tekkies/NodeMcu-LIS3DSH-MQTT-Accelerometer/sandbox/ESP-12E-Programmer/ESP-12E-Programmer-TinyCAD.png

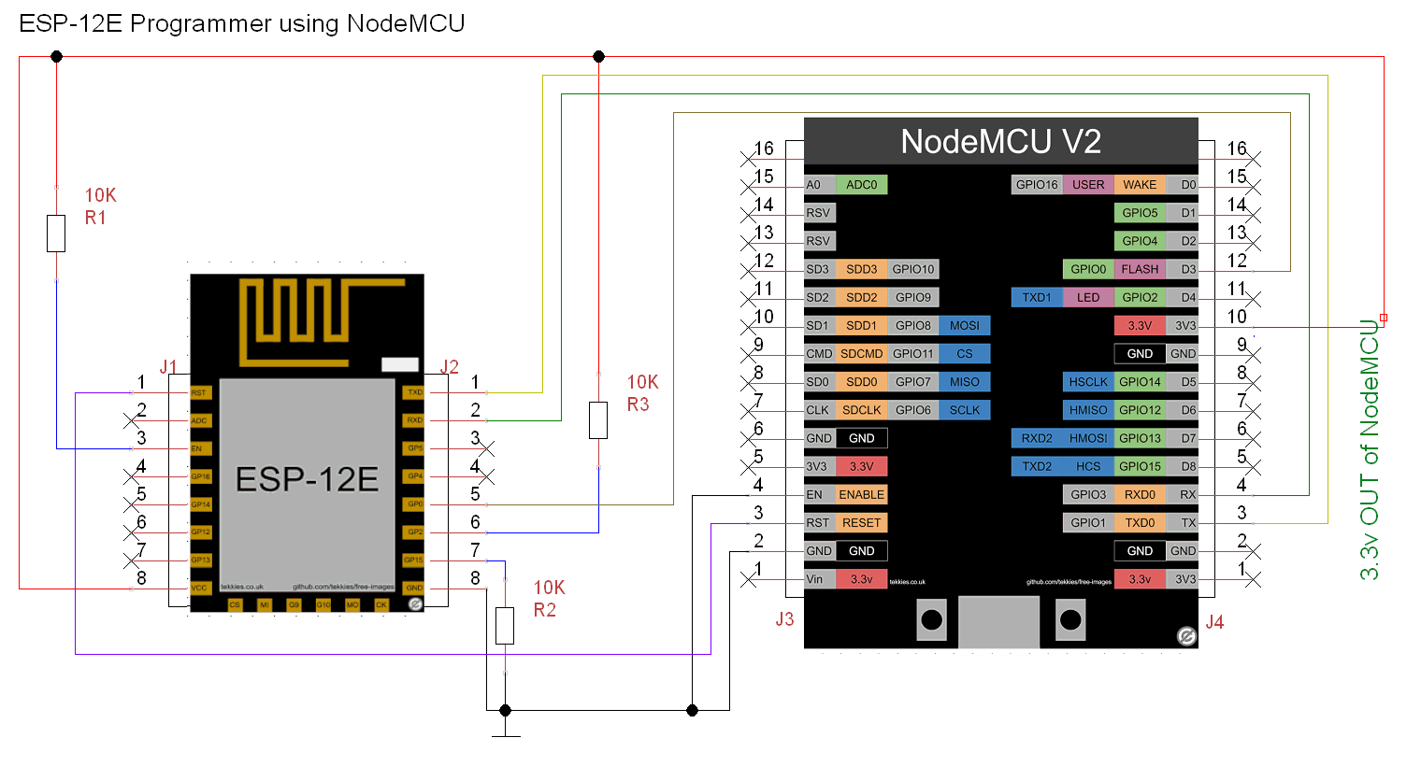
sandbox/ESP-12E-Programmer/ESP-12E-Programmer-TinyCAD.png
