tekkies/NodeMcu-LIS3DSH-MQTT-Accelerometer/hardware/NodeMCU-V2/Stripboard-Layout-FRONT.VeeCAD.pdf

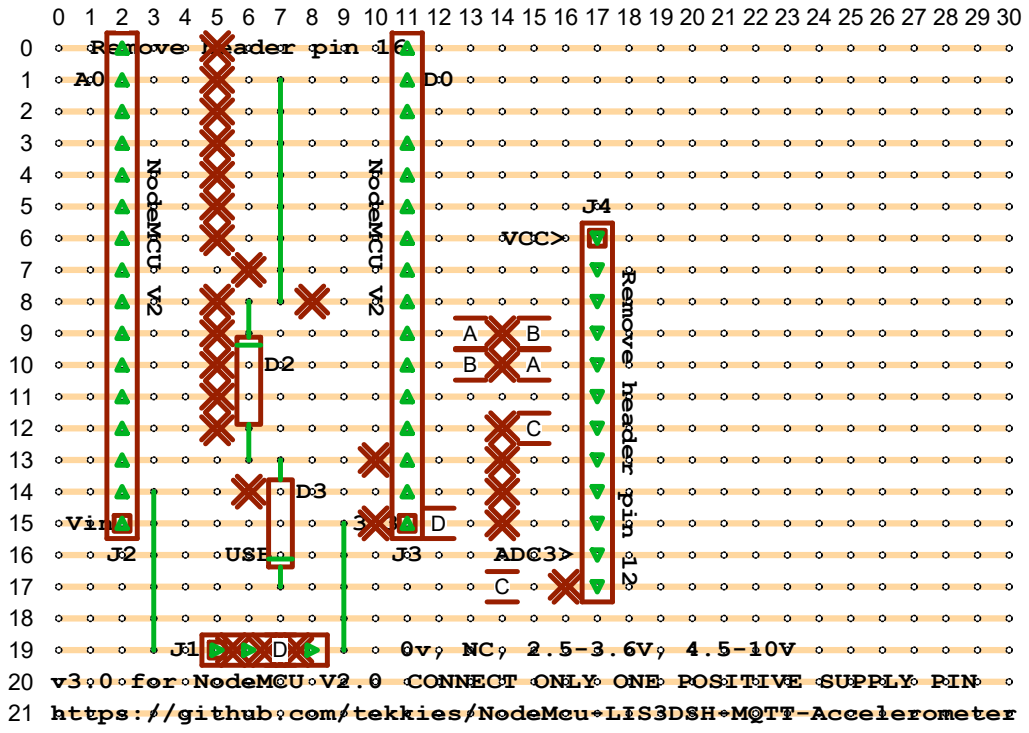
[picture p6: page 1]
ADC3>; VCC>; Remove header pin 16; Vin; USB; v3.0 for NodeMCU V2.0 https://github.com/tekkies/NodeMcu-LIS3DSH-MQTT-Accelerometer; CONNECT ONLY ONE POSITIVE SUPPLY PIN NodeMCU V2; NodeMCU V2; Remove header pin 12 A
