tekkies/NodeMcu-LIS3DSH-MQTT-Accelerometer/hardware/NodeMCU-V2/Stripboard-Layout-REAR.VeeCAD.pdf

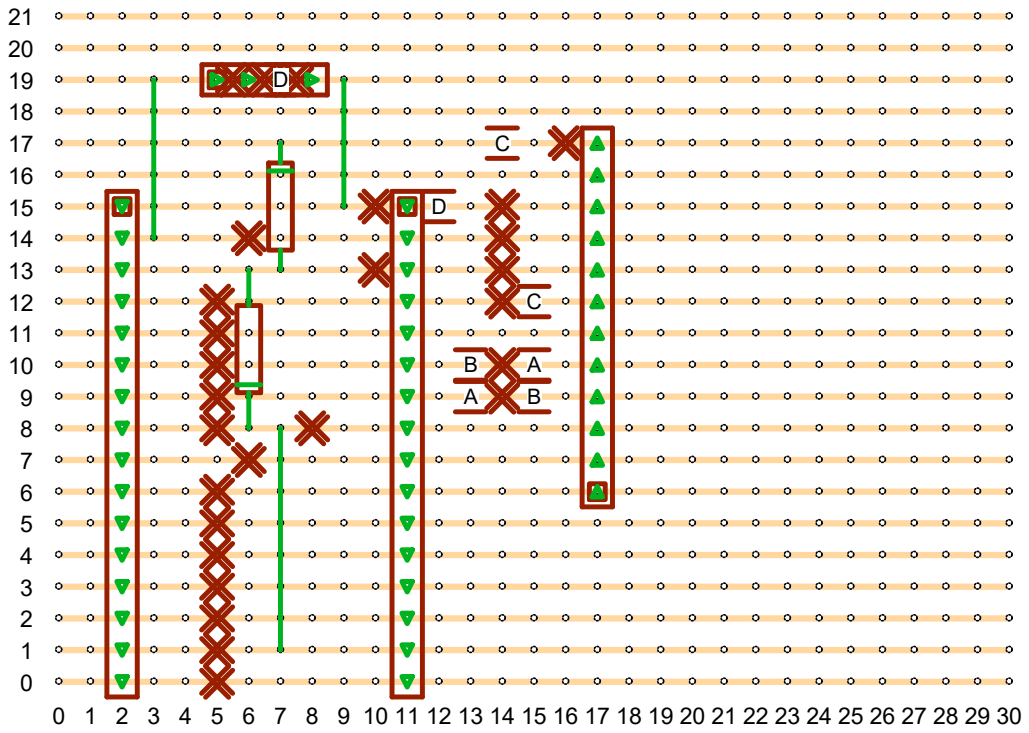
[picture p7: page 1]
