tekkies/NodeMcu-LIS3DSH-MQTT-Accelerometer/(list of files, drawings)

Other design files:
hardware/NodeMCU-V2/Circuit-Diagram-TinyCAD.dsn
sandbox/ESP-12E-Programmer/ESP-12E-Programmer-TinyCAD.dsn
