tekkies/NodeMcu-LIS3DSH-MQTT-Accelerometer/(commit log)

2021-12-30 Flaky epoch timeout
    Sometimes the device just boots into epoch timeout immediately
2021-12-30 Initial TinyCad layout with a few components
    [Circuit-Diagram-TinyCAD.dsn]
2021-12-30 NodeMCU left side pins created
    [Circuit-Diagram-TinyCAD.dsn]
2021-12-30 Symbol Updated with image
    [Circuit-Diagram-TinyCAD.dsn]
2021-12-30 More wiring
    [Circuit-Diagram-TinyCAD.dsn]
2021-12-30 Wired up accelerometer
    [Circuit-Diagram-TinyCAD.dsn]
2021-12-30 Add no-connects
    [Circuit-Diagram-TinyCAD.dsn]
2021-12-30 Resize paper
    [Circuit-Diagram-TinyCAD.dsn]
2021-12-30 Update readme with new circuit diagram
2021-12-30 Imported some shapes into VeeCAD
    [Circuit-Diagram-TinyCAD.dsn]
2021-12-30 Labeled a diode
    [Circuit-Diagram-TinyCAD.dsn]
2021-12-30 Use VeeCAD connectors instead of custom symbols
    [Circuit-Diagram-TinyCAD.dsn]
2021-12-30 Resize connectors
    [Circuit-Diagram-TinyCAD.dsn]
2021-12-30 Fighting SIL connectors
    [Circuit-Diagram-TinyCAD.dsn]
2021-12-30 Added NoConnects
    [Circuit-Diagram-TinyCAD.dsn]
2021-12-30 Messing with snap can unlink non-snapped items
    [Circuit-Diagram-TinyCAD.dsn]
2021-12-30 Layout Accelerometer
    [Circuit-Diagram-TinyCAD.dsn]
2021-12-30 No circuit errors
    [Circuit-Diagram-TinyCAD.dsn]
2021-12-30 Checked connectors are correct distance apart
2021-12-31 Track memory usage
2021-12-31 Sleep the accelerometer, optimise accelerometer first sample and power
2021-12-31 Adjust battery calibration
2021-12-31 Quick script to test X-axis setup
2022-01-01 Better printing
2022-01-01 MILESTONE: Interrupt pin was raised when shaken!
2022-01-01 Connect LIS3DSH interrupt to NodeMCU
    [Circuit-Diagram-TinyCAD.dsn]
2022-01-01 Power-save: Reduce sample rate to 3hz
2022-01-01 Print x,y
2022-01-02 Low power test
2022-01-02 Move code, introduce DEVICE-INFO.lua
2022-01-02 New DEVICE-INFO.lua convention
2022-01-02 Tidy folders
    [Circuit-Diagram-TinyCAD.dsn]
2022-01-02 Fix README.md
    [Circuit-Diagram-TinyCAD.dsn]
2022-01-02 Named OEMNodeMCU Version
    [Circuit-Diagram-TinyCAD.dsn]
2022-01-02 Titled v2.0 for OEM NodeMCU
    [Circuit-Diagram-TinyCAD.dsn]
2022-01-02 Move hardware to OEM-NodeMCU-V2.0 folder
    [Circuit-Diagram-TinyCAD.dsn]
2022-01-03 Change graphic in Circuit-Diagram-TinyCAD.dsn
    [Circuit-Diagram-TinyCAD.dsn]
2022-01-03 Starting ESP12-E programmer design
    [ESP-12E-Programmer-TinyCAD.dsn]
2022-01-03 Laying out programmer
    [ESP-12E-Programmer-TinyCAD.dsn]
2022-01-03 Programmer Layout, needs checking
    [ESP-12E-Programmer-TinyCAD.dsn]
2022-01-03 All wires checked
    [ESP-12E-Programmer-TinyCAD.dsn]
2022-01-03 Tidy layout
    [ESP-12E-Programmer-TinyCAD.dsn]
2022-01-03 Used Inverse labelled NodeMCU
    [ESP-12E-Programmer-TinyCAD.dsn]
2022-01-03 Clean up modified NodeMCU that did not work consistently
    Saw 20uA ONCE only. Then about 1-3mA after that.
    [Circuit-Diagram-TinyCAD.dsn]
2022-01-05 Improved Labelling
    [Circuit-Diagram-TinyCAD.dsn]
2022-01-11 Setup static IP in DEVICE-CONFIG.lua now
2022-01-11 Read 3.3v pin for battery voltage
    Seems off by a bit.
2022-01-12 Prune regulator power source and potential divider
    [Circuit-Diagram-TinyCAD.dsn]
2022-01-12 4-Pin power plug
    [Circuit-Diagram-TinyCAD.dsn]
2022-01-12 Label supply connector J1
2022-01-12 Board v3.0
2022-01-12 Power notes
    [Circuit-Diagram-TinyCAD.dsn]
2022-01-12 Remove obsolete power note
2022-01-13 Switch back to test.mosquitto.org
2022-01-15 Only track Y axis
2022-01-15 State machine status at fixed +-0.6g, not relative
    [characterise-state-machine.lua]
2022-01-15 CONCLUSION: State machine is triggering is currently absolute
    Polling the status, you can see the state machine triggering and untriggering as you rotate and reverse rotation of the Y axis.
2022-01-15 Switched to state machine 2. Still trigging on absolute
2022-01-15 Prevent double triggering - a bit hacky
    [characterise-state-machine.lua]
2022-01-15 Better prevention of double triggering
    [characterise-state-machine.lua]
2022-01-16 Disable LED, sleep for 15 minutes max
